artusiep/PMiM/doc/scheme.jpg

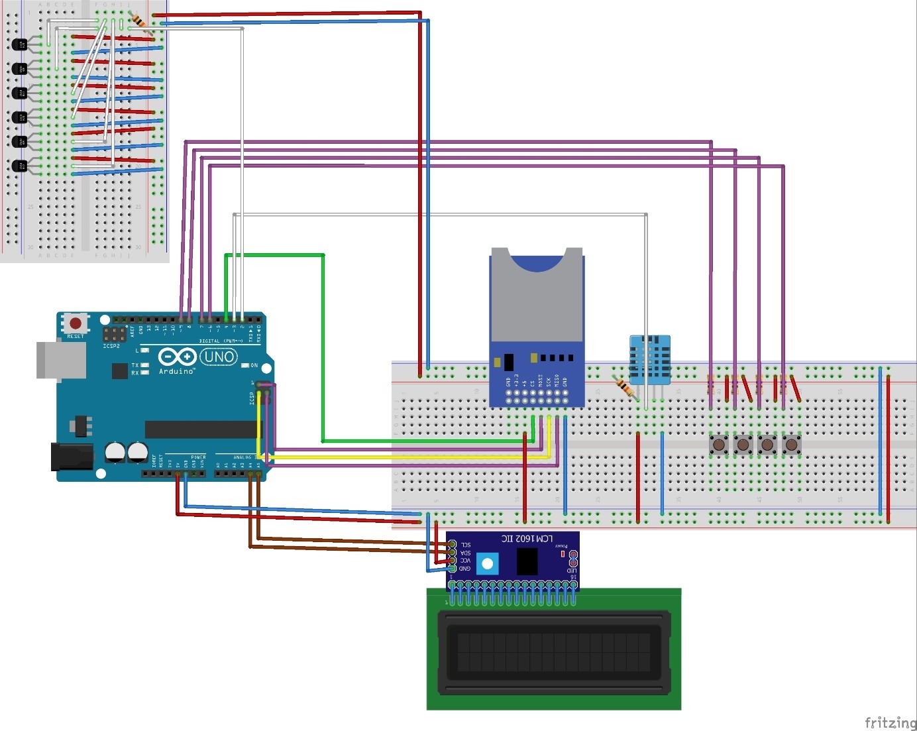
doc/scheme.jpg
